Mikjaer/SpaceApiClient/presentation/Pinout.PNG

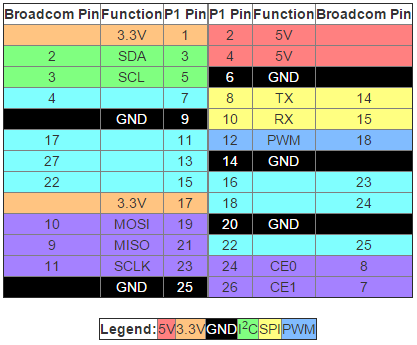
presentation/Pinout.PNG
