Mikjaer/SpaceApiClient/presentation/p1-highlight.png

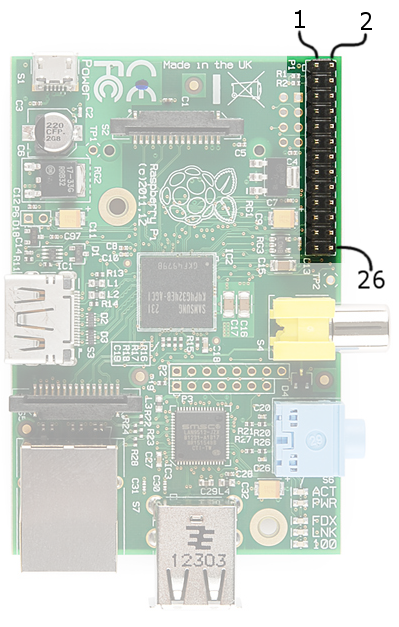
presentation/p1-highlight.png
