Mikjaer/SpaceApiClient/caseplans/README.md

Caseplans - Makerbox SVGs for the SpaceApi box
==============================================

The following files were used with OSAA PhotonSaw to create the SpaceApi box:
We had to split the original file, to fit the two pieces of acrylic that we had sponsored from Bertho.
Also I dropped the front after the first cut, and a corner broke off. 
We tested some better matching holes on the new front, to mount the LEDs without hot-glue.

SpaceApiBox.json : The file saved from [MakerCase.com](http://www.makercase.com) with the original box.
Raspberry_Pi_Dimensions.png : Dimensions of the Raspberry Pi B.
Raspberry-Pi-Mounting-Hole-Template.png : Used to place the mounting holes in the back of the box.
caseplans.svg : The original folded-out box from Makercase.com.
caseplans1.svg : The front and half the sides.
caseplans2.svg : The back and other sides.
test holes.svg : Further tests to find the perfect LED sized hole.
caseplans-nyfront.svg : The final front, with fitting LED holes.
