Mikjaer/SpaceApiClient/presentation/SpaceApi.pptx

## THE SPACE IS CURRENTLY

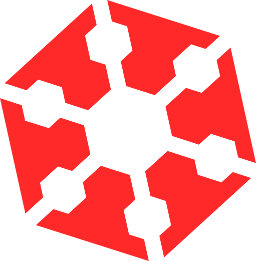
[picture p3: figure]

CLOSED

Notes: SpaceApi i flere versioner:
Robotto: arduino + ethernet shield
Skeen: ESP8266 modul med irc bot
Sidste iteration: Ukendt

## Raspberry PI GPIO


Notes: Flere funktioner: (Legend er forkert)
17 GPIO
TTL-level Serial (RX/TX)
I²C (Grøn)
SPI (Lilla)
PWM Output (Blå)
Ingen analog input / ADC (Kan tilføjes på SPI eller I²C)
Alle GPIO er 3.3V – level conversion kan være nødvendigt…

## Test opstilling

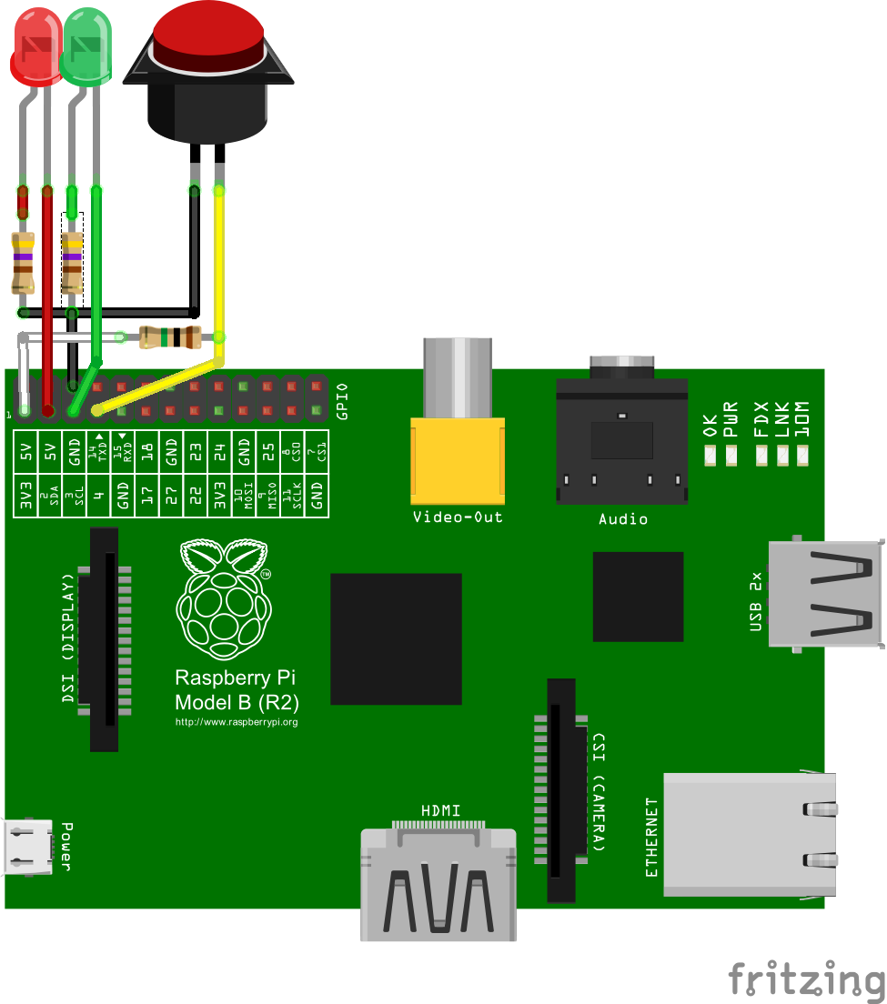
[picture p4: figure]

Notes: Fuglerede
2 LED med seriemodstand, fra GPIO 2 og 3 til GND
Trykknap fra GPIO 4 til GND med 1M pull-up modstand fra 3.3V

## GPIO Ben 2, 3 og 4

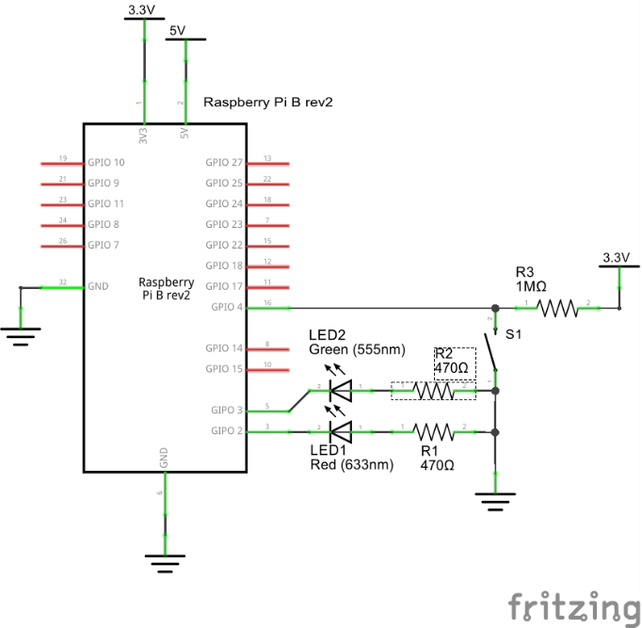
[picture p5: figure]

Notes: Lidt mindre fuglerede.
2 LED med seriemodstand, fra GPIO 2 og 3 til GND
Trykknap fra GPIO 4 til GND med 1M pull-up modstand fra 3.3V

## Python API

# External module imports

import RPi.GPIO as GPIO
# Pin Definitons:

ledPinRed = 2 # Broadcom pin 2 (P1 pin 3) (RED)
ledPinGreen = 3 # Broadcom pin 3 (P1 pin 5) (GREEN)
butPin = 3 # Broadcom pin 4 (P1 pin 7)
# Pin Setup:

GPIO.setmode(GPIO.BCM) # Broadcom pin-numbering scheme
GPIO.setup(ledPinRed, GPIO.OUT) # LED pin set as output
GPIO.setup(ledPinGreen, GPIO.OUT) # LED pin set as output
GPIO.setup(butPin, GPIO.IN, pull_up_down = GPIO.PUD_UP) # Button pin set as input w/ pull-up
GPIO.output(ledPinRed, GPIO.HIGH) # Set Space Closed = ON
GPIO.output(ledPinGreen, GPIO.LOW) # Set Space Open = OFF

Notes: Opsætning af Python script
BroadCom Vs Board numbering scheme: Vi bruger Broadcoms.
Sæt Inputs og Outputs + evt PullUp flag.

## Python API

try:
while 1:
if GPIO.input(butPin): # button is released
if (spaceApi.status == spaceApi.OPEN): # light the green LED
GPIO.output(ledPinRed, GPIO.LOW)
GPIO.output(ledPinGreen, GPIO.HIGH)
else: # light the red LED
GPIO.output(ledPinRed, GPIO.HIGH)
GPIO.output(ledPinGreen, GPIO.LOW)
time.sleep(5) # Wait 5 seconds, before we check again
else: # button is pressed:
if (spaceApi.status == spaceApi.OPEN): # Space is open, then close it
spaceApi.setStatus(spaceApi.CLOSED)
else: # Space is closed, then open it
spaceApi.setStatus(spaceApi.OPEN)
except KeyboardInterrupt: # If CTRL+C is pressed, exit cleanly:
GPIO.cleanup() # cleanup all GPIO

Notes: Statemachine
Kun eksempelkode, jeg har ikke den rigtige kode…
Den rigtige kode poller kun hvert 20. sekund, men poller knappen tit.
Efter tryk på knappen, polles lidt oftere for state change på SpaceAPI.

## MakerCase.com

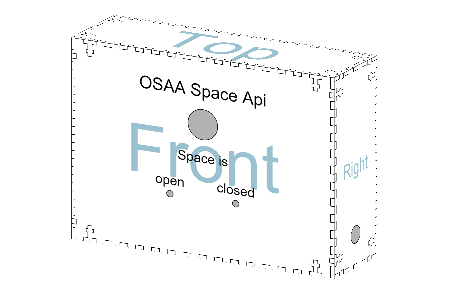
[picture p6: figure]

Notes: Online værktøj til laserskårne kasser.
Hjørner monteret med t-slots og M3 bolte.
Gemmer i JSON
Eksporterer i SVG
Skal igennem InkScape, for at få tilføjet speed, power, skalering og lag.

## OSAA Photon Saw

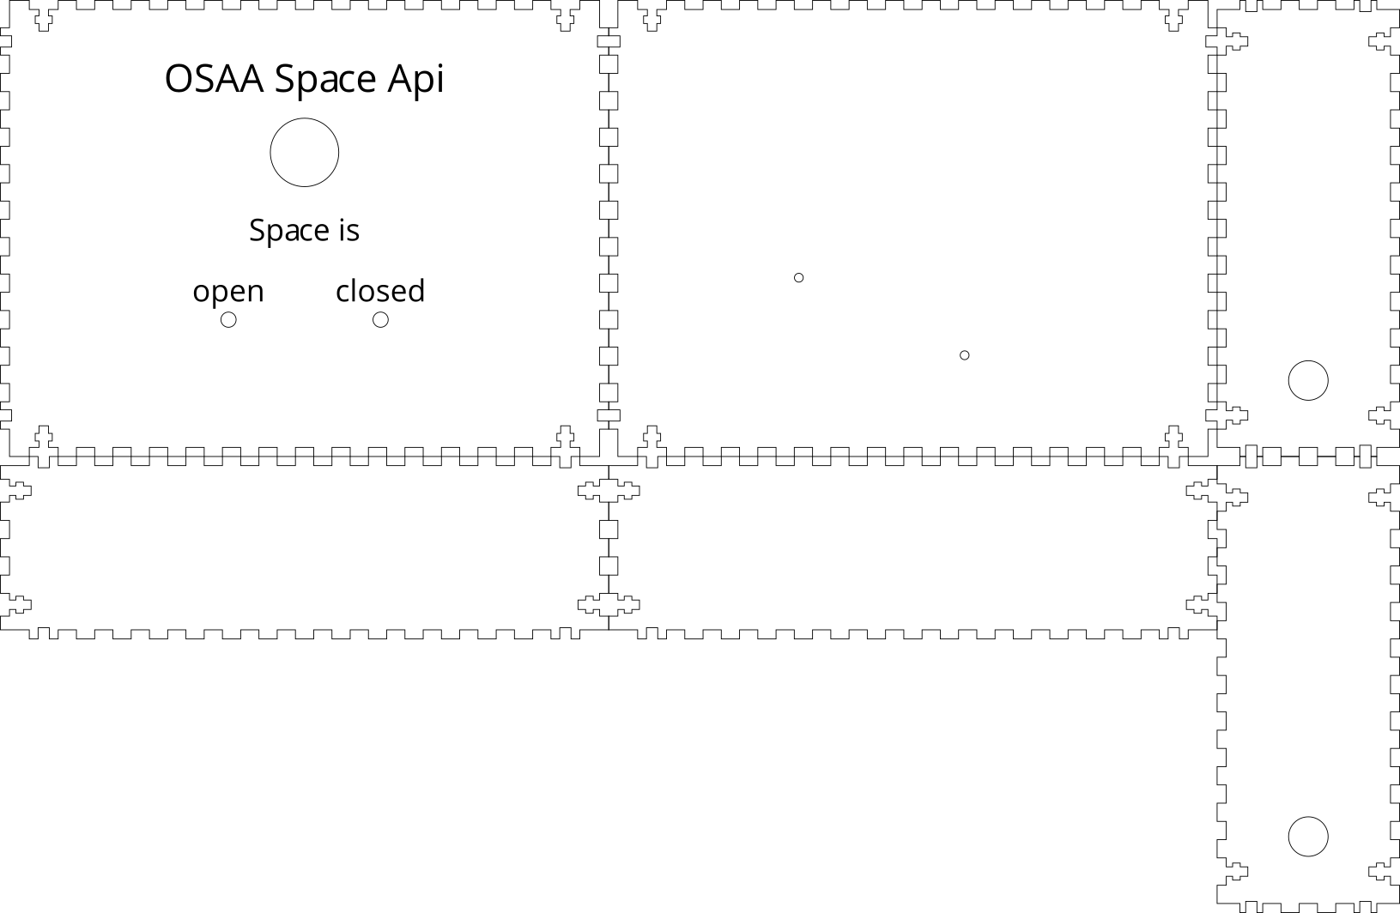
[picture p7: figure]

Notes: Efter tur i InkScape
Filen blev delt yderligere op, af hensyn til vores pladestørrelser.
2 skruehuller i bagpladen, til spacere, til montering af Pien

## Montering

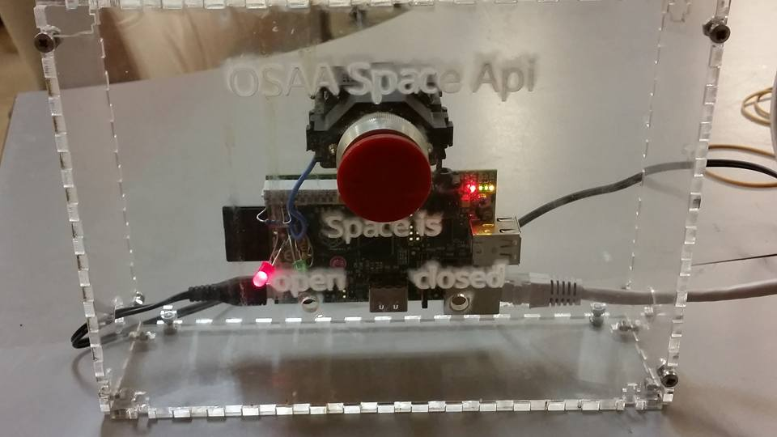
[picture p8: figure]

Notes: Første samletest.
Hullet til Ethernet er 1mm for lille. Stikket blev filet til så det passede.
Huller til LEDs er en anelse for store, LED’s falder ud hvis de ikke limes.
Fronten ødelagt :-/
Mangler hjørne + er skåret uden plastic, så bogstaverne er ‘brændte’.
Færdig lørdag morgen kl 4.

## Deployment

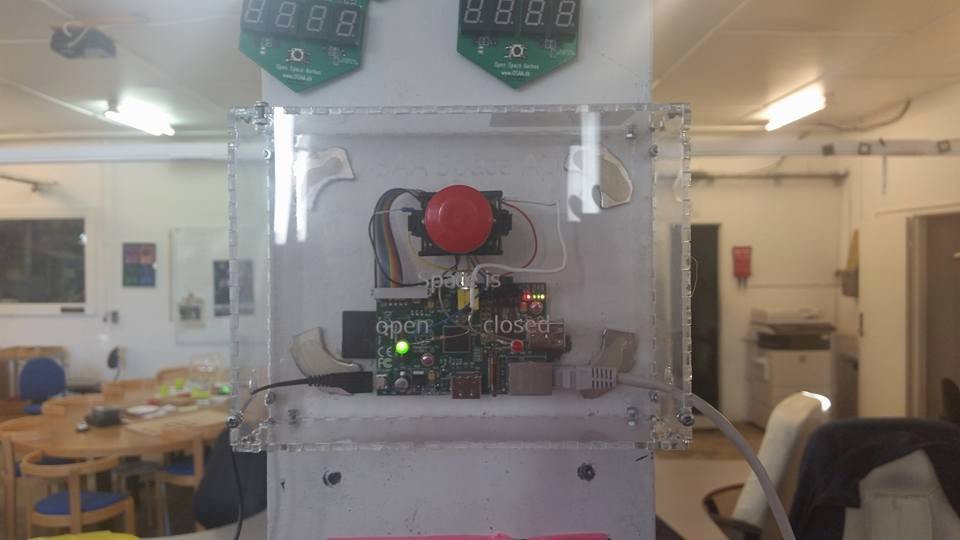
[picture p9: figure]

Notes: Endelig deployment søndag
Ny front med meget pænere bogstaver.
Lim + Magneter, for montering på stolpe.
Huller for LED’s tilpasset, så LED’s ikke skal limes
Ny lodning på fladkabel: Meget pænere end fuglereden.
Stadig kun 1,7w PSU…

## THE SPACE IS CURRENTLY

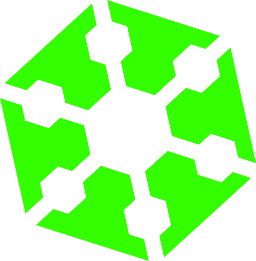
[picture p10: figure]

OPEN

Notes: Great Success!
