Mikjaer/SpaceApiClient/caseplans/Raspberry_Pi_Dimensions.png

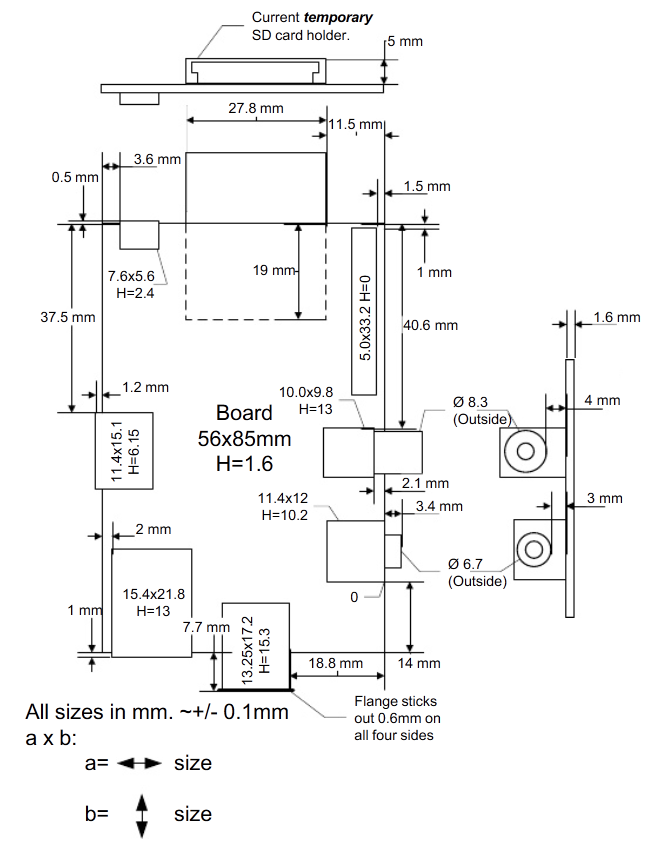
caseplans/Raspberry_Pi_Dimensions.png
