Mikjaer/SpaceApiClient/presentation/osaa_bg.jpg

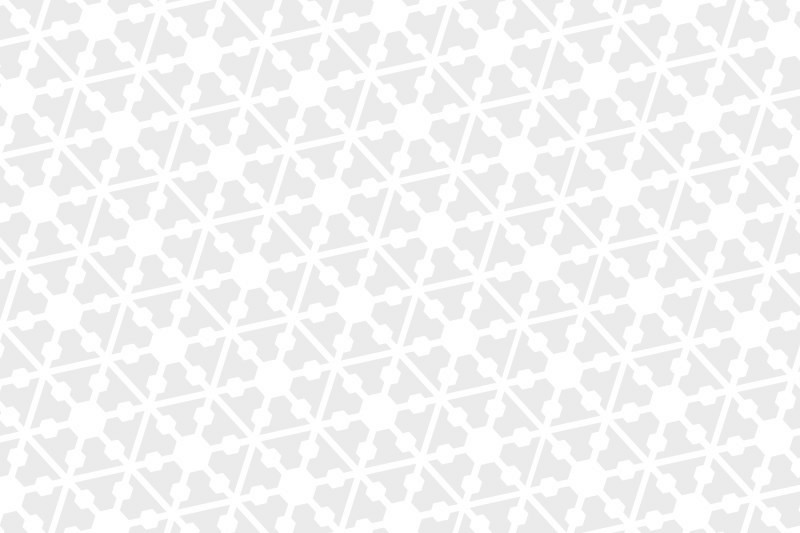
presentation/osaa_bg.jpg
