Mikjaer/SpaceApiClient/(list of files, drawings)

Other design files:
presentation/OSAA SpaceApi.fzz
