Mikjaer/SpaceApiClient/(commit log)

2015-11-19 Added Case Plans for OSAA PhotonSaw
2015-11-19 Added T3 Presentation
    [OSAA SpaceApi.fzz]
